adafruit/USB-Power-Gauge/usbpowergauge sch.png

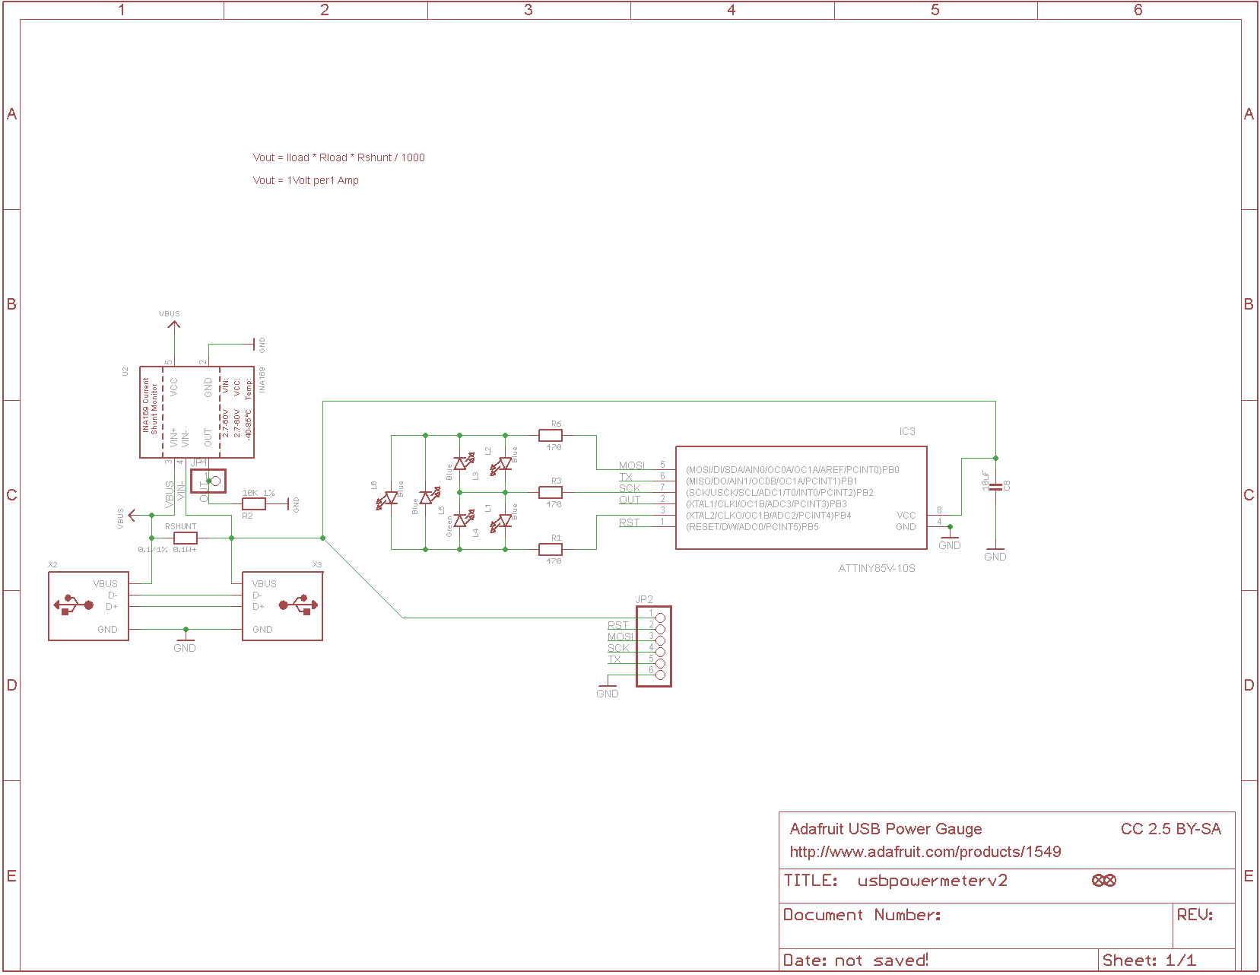
usbpowergauge sch.png
